wudidamaozi/signal_sensing_accelerator/report/figures/board_top.jpg

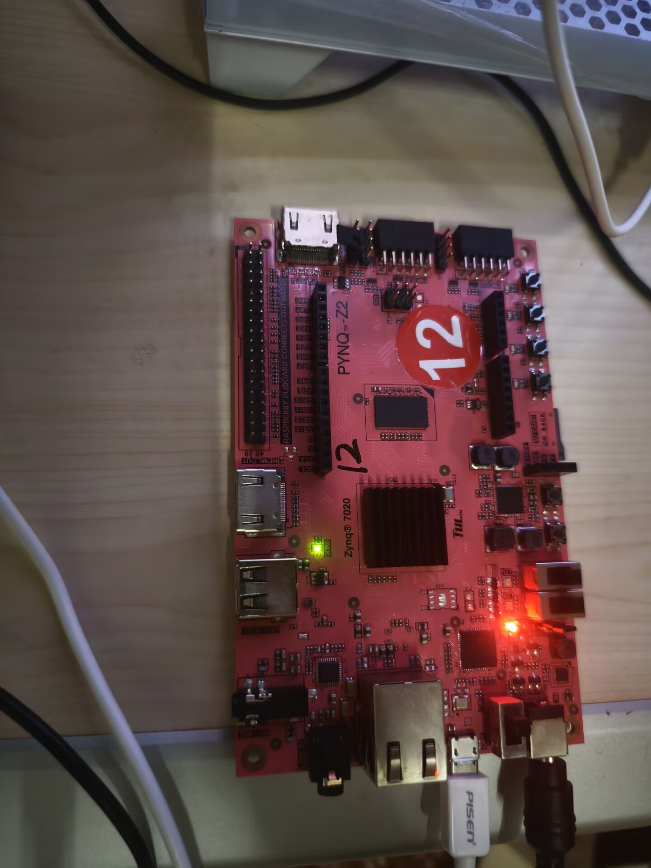
report/figures/board_top.jpg
