wudidamaozi/signal_sensing_accelerator/report/figures/board_oblique.jpg

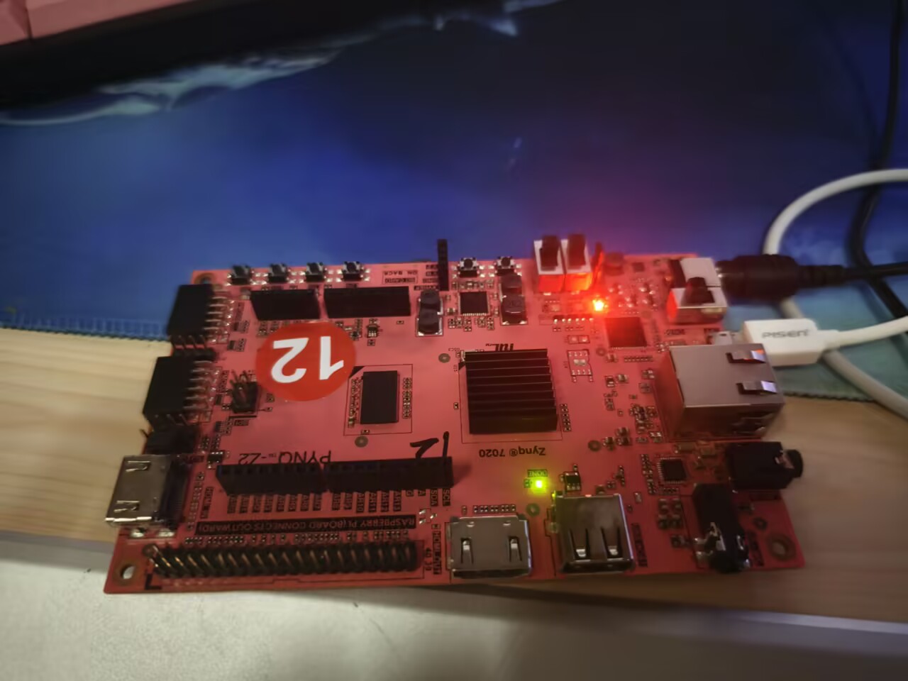
report/figures/board_oblique.jpg
