wudidamaozi/signal_sensing_accelerator/report/README.md

# 基于FPGA的信号感知加速系统技术文档

本目录的正式提交文档为V8，共28页。

- **[阅读技术文档 PDF](基于FPGA的信号感知加速系统技术文档.pdf)**
- **[下载技术文档 Word](基于FPGA的信号感知加速系统技术文档.docx)**

文档内容、性能数据与已确认版本一致，本次只调整文件名称与阅读入口。正式Word与PDF采用完整中文作品名称，源代码与脚本目录保留英文。

## 配套材料

- [报告说明](design_report.md)
- [图表与实板照片](figures/)
- [大模型辅助设计过程](ai_collaboration.md)及[交互选段](ai_collaboration.jsonl)
- [四种方法性能数据](four_method_board_results.csv)
- [原始结果与身份记录](evidence/)
- [从零复现说明](reproduction.md)
