wudidamaozi/signal_sensing_accelerator/src/rtl/README.md

# RTL source index

相同文件按内容合并，不合并同名但不同的私有实现。每个variant均可独立综合。

## classification_native

- `picorv32.v` → [picorv32_0836050971.v](common/picorv32_0836050971.v)
- `int8_accelerator_mmio_m33.sv` → [int8_accelerator_mmio_m33_3799ce2c50.sv](common/int8_accelerator_mmio_m33_3799ce2c50.sv)
- `int8_gemm_controller_m32.sv` → [int8_gemm_controller_m32_1716969adc.sv](common/int8_gemm_controller_m32_1716969adc.sv)
- `int8_input_window_loader_m33.sv` → [int8_input_window_loader_m33_1b4d976766.sv](common/int8_input_window_loader_m33_1b4d976766.sv)
- `int8_layer_postprocess_controller.sv` → [int8_layer_postprocess_controller_28c6c0fac2.sv](common/int8_layer_postprocess_controller_28c6c0fac2.sv)
- `int8_max_pool2.sv` → [int8_max_pool2_0a0ae2d4c0.sv](common/int8_max_pool2_0a0ae2d4c0.sv)
- `int8_outer_product_4x4.sv` → [int8_outer_product_4x4_0622b5f9d8.sv](common/int8_outer_product_4x4_0622b5f9d8.sv)
- `int8_requantize_relu.sv` → [int8_requantize_relu_98dfb3d442.sv](common/int8_requantize_relu_98dfb3d442.sv)
- `int8_stream_gap.sv` → [int8_stream_gap_971eea06c3.sv](common/int8_stream_gap_971eea06c3.sv)
- `int8_weight_tile_loader.sv` → [int8_weight_tile_loader_4e19926822.sv](common/int8_weight_tile_loader_4e19926822.sv)
- `m30_network_replay.sv` → [m30_network_replay_6fcaa0b044.sv](common/m30_network_replay_6fcaa0b044.sv)
- `picorv32_accel_soc.sv` → [picorv32_accel_soc_ba20cb8e85.sv](common/picorv32_accel_soc_ba20cb8e85.sv)
- `pynq_r14_m37_usb_top.sv` → [pynq_r14_m37_usb_top_d0eacc5328.sv](common/pynq_r14_m37_usb_top_d0eacc5328.sv)
- `simple_dual_port_bram_32.sv` → [simple_dual_port_bram_32_69316b4be8.sv](common/simple_dual_port_bram_32_69316b4be8.sv)
- `simple_dual_port_bram_8.sv` → [simple_dual_port_bram_8_8822d650fa.sv](common/simple_dual_port_bram_8_8822d650fa.sv)

## classification_hls4ml

- `picorv32.v` → [picorv32_0836050971.v](common/picorv32_0836050971.v)
- `public_cnn.v` → [public_cnn_613a852ffb.v](common/public_cnn_613a852ffb.v)
- `public_cnn_compute_output_buffer_1d_array_ap_int_8_2u_array_ap_int_32_32u_config2_s.v` → [public_cnn_compute_output_buffer_1d_array_ap_int_8_2u_array_ap_i_f963e03465.v](common/public_cnn_compute_output_buffer_1d_array_ap_int_8_2u_array_ap_i_f963e03465.v)
- `public_cnn_compute_output_buffer_1d_array_ap_int_8_32u_array_ap_int_32_64u_config5_s.v` → [public_cnn_compute_output_buffer_1d_array_ap_int_8_32u_array_ap__8306ac9084.v](common/public_cnn_compute_output_buffer_1d_array_ap_int_8_32u_array_ap__8306ac9084.v)
- `public_cnn_compute_output_buffer_1d_array_ap_int_8_64u_array_ap_int_32_64u_config8_s.v` → [public_cnn_compute_output_buffer_1d_array_ap_int_8_64u_array_ap__76f975a701.v](common/public_cnn_compute_output_buffer_1d_array_ap_int_8_64u_array_ap__76f975a701.v)
- `public_cnn_conv_1d_cl_array_ap_int_8_2u_array_ap_int_32_32u_config2_s.v` → [public_cnn_conv_1d_cl_array_ap_int_8_2u_array_ap_int_32_32u_conf_8c45bdf6fb.v](common/public_cnn_conv_1d_cl_array_ap_int_8_2u_array_ap_int_32_32u_conf_8c45bdf6fb.v)
- `public_cnn_conv_1d_cl_array_ap_int_8_32u_array_ap_int_32_64u_config5_s.v` → [public_cnn_conv_1d_cl_array_ap_int_8_32u_array_ap_int_32_64u_con_a865e45c8b.v](common/public_cnn_conv_1d_cl_array_ap_int_8_32u_array_ap_int_32_64u_con_a865e45c8b.v)
- `public_cnn_conv_1d_cl_array_ap_int_8_64u_array_ap_int_32_64u_config8_s.v` → [public_cnn_conv_1d_cl_array_ap_int_8_64u_array_ap_int_32_64u_con_ced2e0c10d.v](common/public_cnn_conv_1d_cl_array_ap_int_8_64u_array_ap_int_32_64u_con_ced2e0c10d.v)
- `public_cnn_dense_array_ap_int_8_64u_array_ap_int_32_4u_config11_s.v` → [public_cnn_dense_array_ap_int_8_64u_array_ap_int_32_4u_config11__b1404e3907.v](common/public_cnn_dense_array_ap_int_8_64u_array_ap_int_32_4u_config11__b1404e3907.v)
- `public_cnn_dense_resource_rf_gt_nin_rem0_ap_int_8_ap_int_32_config2_mult_s.v` → [public_cnn_dense_resource_rf_gt_nin_rem0_ap_int_8_ap_int_32_conf_ee845bf7ef.v](common/public_cnn_dense_resource_rf_gt_nin_rem0_ap_int_8_ap_int_32_conf_ee845bf7ef.v)
- `public_cnn_dense_resource_rf_gt_nin_rem0_ap_int_8_ap_int_32_config2_mult_s_outidx_2.v` → [public_cnn_dense_resource_rf_gt_nin_rem0_ap_int_8_ap_int_32_conf_812364fb16.v](common/public_cnn_dense_resource_rf_gt_nin_rem0_ap_int_8_ap_int_32_conf_812364fb16.v)
- `public_cnn_dense_resource_rf_gt_nin_rem0_ap_int_8_ap_int_32_config2_mult_s_w2_V.v` → [public_cnn_dense_resource_rf_gt_nin_rem0_ap_int_8_ap_int_32_conf_0eb14951e0.v](common/public_cnn_dense_resource_rf_gt_nin_rem0_ap_int_8_ap_int_32_conf_0eb14951e0.v)
- `public_cnn_dense_resource_rf_gt_nin_rem0_ap_int_8_ap_int_32_config5_mult_s.v` → [public_cnn_dense_resource_rf_gt_nin_rem0_ap_int_8_ap_int_32_conf_16612c6930.v](common/public_cnn_dense_resource_rf_gt_nin_rem0_ap_int_8_ap_int_32_conf_16612c6930.v)
- `public_cnn_dense_resource_rf_gt_nin_rem0_ap_int_8_ap_int_32_config5_mult_s_outidx_1.v` → [public_cnn_dense_resource_rf_gt_nin_rem0_ap_int_8_ap_int_32_conf_3170edeac6.v](common/public_cnn_dense_resource_rf_gt_nin_rem0_ap_int_8_ap_int_32_conf_3170edeac6.v)
- `public_cnn_dense_resource_rf_gt_nin_rem0_ap_int_8_ap_int_32_config5_mult_s_w5_V.v` → [public_cnn_dense_resource_rf_gt_nin_rem0_ap_int_8_ap_int_32_conf_83562274df.v](common/public_cnn_dense_resource_rf_gt_nin_rem0_ap_int_8_ap_int_32_conf_83562274df.v)
- `public_cnn_dense_resource_rf_gt_nin_rem0_ap_int_8_ap_int_32_config8_mult_s.v` → [public_cnn_dense_resource_rf_gt_nin_rem0_ap_int_8_ap_int_32_conf_4edea8b71d.v](common/public_cnn_dense_resource_rf_gt_nin_rem0_ap_int_8_ap_int_32_conf_4edea8b71d.v)
- `public_cnn_dense_resource_rf_gt_nin_rem0_ap_int_8_ap_int_32_config8_mult_s_outidx.v` → [public_cnn_dense_resource_rf_gt_nin_rem0_ap_int_8_ap_int_32_conf_05a0e2ae97.v](common/public_cnn_dense_resource_rf_gt_nin_rem0_ap_int_8_ap_int_32_conf_05a0e2ae97.v)
- `public_cnn_dense_resource_rf_gt_nin_rem0_ap_int_8_ap_int_32_config8_mult_s_w8_V.v` → [public_cnn_dense_resource_rf_gt_nin_rem0_ap_int_8_ap_int_32_conf_f6bc840b84.v](common/public_cnn_dense_resource_rf_gt_nin_rem0_ap_int_8_ap_int_32_conf_f6bc840b84.v)
- `public_cnn_dense_resource_rf_leq_nin_ap_int_8_ap_int_32_config11_s.v` → [public_cnn_dense_resource_rf_leq_nin_ap_int_8_ap_int_32_config11_7f0264f9b0.v](common/public_cnn_dense_resource_rf_leq_nin_ap_int_8_ap_int_32_config11_7f0264f9b0.v)
- `public_cnn_dense_resource_rf_leq_nin_ap_int_8_ap_int_32_config11_s_w11_V.v` → [public_cnn_dense_resource_rf_leq_nin_ap_int_8_ap_int_32_config11_0605cbb6cc.v](common/public_cnn_dense_resource_rf_leq_nin_ap_int_8_ap_int_32_config11_0605cbb6cc.v)
- `public_cnn_edge_gap_array_ap_int_8_64u_array_ap_int_8_64u_config10_s.v` → [public_cnn_edge_gap_array_ap_int_8_64u_array_ap_int_8_64u_config_59c98af666.v](common/public_cnn_edge_gap_array_ap_int_8_64u_array_ap_int_8_64u_config_59c98af666.v)
- `public_cnn_edge_requant_array_ap_int_32_32u_array_ap_int_8_32u_config3_s.v` → [public_cnn_edge_requant_array_ap_int_32_32u_array_ap_int_8_32u_c_f088b455ca.v](common/public_cnn_edge_requant_array_ap_int_32_32u_array_ap_int_8_32u_c_f088b455ca.v)
- `public_cnn_edge_requant_array_ap_int_32_64u_array_ap_int_8_64u_config6_s.v` → [public_cnn_edge_requant_array_ap_int_32_64u_array_ap_int_8_64u_c_c8b5be7ced.v](common/public_cnn_edge_requant_array_ap_int_32_64u_array_ap_int_8_64u_c_c8b5be7ced.v)
- `public_cnn_edge_requant_array_ap_int_32_64u_array_ap_int_8_64u_config9_s.v` → [public_cnn_edge_requant_array_ap_int_32_64u_array_ap_int_8_64u_c_0c2435c09d.v](common/public_cnn_edge_requant_array_ap_int_32_64u_array_ap_int_8_64u_c_0c2435c09d.v)
- `public_cnn_fifo_w1024_d2_S.v` → [public_cnn_fifo_w1024_d2_s_4359fc197e.v](common/public_cnn_fifo_w1024_d2_s_4359fc197e.v)
- `public_cnn_fifo_w16_d2_S.v` → [public_cnn_fifo_w16_d2_s_8f4cb74737.v](common/public_cnn_fifo_w16_d2_s_8f4cb74737.v)
- `public_cnn_fifo_w2048_d2_S.v` → [public_cnn_fifo_w2048_d2_s_a7a66d2959.v](common/public_cnn_fifo_w2048_d2_s_a7a66d2959.v)
- `public_cnn_fifo_w256_d2_S.v` → [public_cnn_fifo_w256_d2_s_690677c5bc.v](common/public_cnn_fifo_w256_d2_s_690677c5bc.v)
- `public_cnn_fifo_w512_d1_S.v` → [public_cnn_fifo_w512_d1_s_ea1562b911.v](common/public_cnn_fifo_w512_d1_s_ea1562b911.v)
- `public_cnn_fifo_w512_d2_S.v` → [public_cnn_fifo_w512_d2_s_46d1deb5f7.v](common/public_cnn_fifo_w512_d2_s_46d1deb5f7.v)
- `public_cnn_mac_muladd_8s_8s_16s_17_4_1.v` → [public_cnn_mac_muladd_8s_8s_16s_17_4_1_40efa62376.v](common/public_cnn_mac_muladd_8s_8s_16s_17_4_1_40efa62376.v)
- `public_cnn_mac_muladd_8s_8s_32ns_32_4_1.v` → [public_cnn_mac_muladd_8s_8s_32ns_32_4_1_18172d5f05.v](common/public_cnn_mac_muladd_8s_8s_32ns_32_4_1_18172d5f05.v)
- `public_cnn_mul_8s_8s_16_1_1.v` → [public_cnn_mul_8s_8s_16_1_1_e2bcf43006.v](common/public_cnn_mul_8s_8s_16_1_1_e2bcf43006.v)
- `public_cnn_mux_164_8_1_1.v` → [public_cnn_mux_164_8_1_1_4d54957741.v](common/public_cnn_mux_164_8_1_1_4d54957741.v)
- `public_cnn_mux_42_32_1_1.v` → [public_cnn_mux_42_32_1_1_5a4bb4b7b5.v](common/public_cnn_mux_42_32_1_1_5a4bb4b7b5.v)
- `public_cnn_mux_646_32_1_1.v` → [public_cnn_mux_646_32_1_1_a496ced3c2.v](common/public_cnn_mux_646_32_1_1_a496ced3c2.v)
- `public_cnn_mux_646_8_1_1.v` → [public_cnn_mux_646_8_1_1_faf9fe0a66.v](common/public_cnn_mux_646_8_1_1_faf9fe0a66.v)
- `public_cnn_pooling1d_cl_array_ap_int_8_32u_array_ap_int_8_32u_config4_s.v` → [public_cnn_pooling1d_cl_array_ap_int_8_32u_array_ap_int_8_32u_co_f8a008766f.v](common/public_cnn_pooling1d_cl_array_ap_int_8_32u_array_ap_int_8_32u_co_f8a008766f.v)
- `public_cnn_pooling1d_cl_array_ap_int_8_64u_array_ap_int_8_64u_config7_s.v` → [public_cnn_pooling1d_cl_array_ap_int_8_64u_array_ap_int_8_64u_co_a042e5c248.v](common/public_cnn_pooling1d_cl_array_ap_int_8_64u_array_ap_int_8_64u_co_a042e5c248.v)
- `public_cnn_regslice_both.v` → [public_cnn_regslice_both_455fa0e3b6.v](common/public_cnn_regslice_both_455fa0e3b6.v)
- `public_cnn_start_for_conv_1d_cl_array_ap_int_8_2u_array_ap_int_32_32u_config2_U0.v` → [public_cnn_start_for_conv_1d_cl_array_ap_int_8_2u_array_ap_int_3_fc5bb173f6.v](common/public_cnn_start_for_conv_1d_cl_array_ap_int_8_2u_array_ap_int_3_fc5bb173f6.v)
- `public_cnn_start_for_conv_1d_cl_array_ap_int_8_32u_array_ap_int_32_64u_config5_U0.v` → [public_cnn_start_for_conv_1d_cl_array_ap_int_8_32u_array_ap_int__700c8c4683.v](common/public_cnn_start_for_conv_1d_cl_array_ap_int_8_32u_array_ap_int__700c8c4683.v)
- `public_cnn_start_for_conv_1d_cl_array_ap_int_8_64u_array_ap_int_32_64u_config8_U0.v` → [public_cnn_start_for_conv_1d_cl_array_ap_int_8_64u_array_ap_int__f5fe1c8c80.v](common/public_cnn_start_for_conv_1d_cl_array_ap_int_8_64u_array_ap_int__f5fe1c8c80.v)
- `public_cnn_start_for_dense_array_ap_int_8_64u_array_ap_int_32_4u_config11_U0.v` → [public_cnn_start_for_dense_array_ap_int_8_64u_array_ap_int_32_4u_1f6f777111.v](common/public_cnn_start_for_dense_array_ap_int_8_64u_array_ap_int_32_4u_1f6f777111.v)
- `public_cnn_start_for_edge_gap_array_ap_int_8_64u_array_ap_int_8_64u_config10_U0.v` → [public_cnn_start_for_edge_gap_array_ap_int_8_64u_array_ap_int_8__ca4464d58e.v](common/public_cnn_start_for_edge_gap_array_ap_int_8_64u_array_ap_int_8__ca4464d58e.v)
- `public_cnn_start_for_edge_requant_array_ap_int_32_32u_array_ap_int_8_32u_config3_U0.v` → [public_cnn_start_for_edge_requant_array_ap_int_32_32u_array_ap_i_4d4d6b3682.v](common/public_cnn_start_for_edge_requant_array_ap_int_32_32u_array_ap_i_4d4d6b3682.v)
- `public_cnn_start_for_edge_requant_array_ap_int_32_64u_array_ap_int_8_64u_config6_U0.v` → [public_cnn_start_for_edge_requant_array_ap_int_32_64u_array_ap_i_9abb88d0a9.v](common/public_cnn_start_for_edge_requant_array_ap_int_32_64u_array_ap_i_9abb88d0a9.v)
- `public_cnn_start_for_edge_requant_array_ap_int_32_64u_array_ap_int_8_64u_config9_U0.v` → [public_cnn_start_for_edge_requant_array_ap_int_32_64u_array_ap_i_6f36ac7276.v](common/public_cnn_start_for_edge_requant_array_ap_int_32_64u_array_ap_i_6f36ac7276.v)
- `public_cnn_start_for_pooling1d_cl_array_ap_int_8_32u_array_ap_int_8_32u_config4_U0.v` → [public_cnn_start_for_pooling1d_cl_array_ap_int_8_32u_array_ap_in_1ae8a94765.v](common/public_cnn_start_for_pooling1d_cl_array_ap_int_8_32u_array_ap_in_1ae8a94765.v)
- `public_cnn_start_for_pooling1d_cl_array_ap_int_8_64u_array_ap_int_8_64u_config7_U0.v` → [public_cnn_start_for_pooling1d_cl_array_ap_int_8_64u_array_ap_in_56fe2aba35.v](common/public_cnn_start_for_pooling1d_cl_array_ap_int_8_64u_array_ap_in_56fe2aba35.v)
- `public_cnn_start_for_zeropad1d_cl_array_ap_int_8_32u_array_ap_int_8_32u_config13_U0.v` → [public_cnn_start_for_zeropad1d_cl_array_ap_int_8_32u_array_ap_in_3bcb6ae762.v](common/public_cnn_start_for_zeropad1d_cl_array_ap_int_8_32u_array_ap_in_3bcb6ae762.v)
- `public_cnn_start_for_zeropad1d_cl_array_ap_int_8_64u_array_ap_int_8_64u_config14_U0.v` → [public_cnn_start_for_zeropad1d_cl_array_ap_int_8_64u_array_ap_in_d10adf3a59.v](common/public_cnn_start_for_zeropad1d_cl_array_ap_int_8_64u_array_ap_in_d10adf3a59.v)
- `public_cnn_zeropad1d_cl_array_ap_int_8_2u_array_ap_int_8_2u_config12_s.v` → [public_cnn_zeropad1d_cl_array_ap_int_8_2u_array_ap_int_8_2u_conf_7416b15e02.v](common/public_cnn_zeropad1d_cl_array_ap_int_8_2u_array_ap_int_8_2u_conf_7416b15e02.v)
- `public_cnn_zeropad1d_cl_array_ap_int_8_32u_array_ap_int_8_32u_config13_s.v` → [public_cnn_zeropad1d_cl_array_ap_int_8_32u_array_ap_int_8_32u_co_c487a04ace.v](common/public_cnn_zeropad1d_cl_array_ap_int_8_32u_array_ap_int_8_32u_co_c487a04ace.v)
- `public_cnn_zeropad1d_cl_array_ap_int_8_64u_array_ap_int_8_64u_config14_s.v` → [public_cnn_zeropad1d_cl_array_ap_int_8_64u_array_ap_int_8_64u_co_c01829a652.v](common/public_cnn_zeropad1d_cl_array_ap_int_8_64u_array_ap_int_8_64u_co_c01829a652.v)
- `hls_network_mmio.sv` → [hls_network_mmio_cf8da6c49e.sv](common/hls_network_mmio_cf8da6c49e.sv)
- `hls_picorv32_soc.sv` → [hls_picorv32_soc_1f9c38afa6.sv](common/hls_picorv32_soc_1f9c38afa6.sv)
- `pynq_r14_hls_usb_top.sv` → [pynq_r14_hls_usb_top_c6f5b64761.sv](common/pynq_r14_hls_usb_top_c6f5b64761.sv)

## classification_im2col

- `picorv32.v` → [picorv32_0836050971.v](common/picorv32_0836050971.v)
- `int8_accelerator_mmio_m33.sv` → [int8_accelerator_mmio_m33_3799ce2c50.sv](common/int8_accelerator_mmio_m33_3799ce2c50.sv)
- `int8_gemm_controller_m32.sv` → [int8_gemm_controller_m32_1716969adc.sv](common/int8_gemm_controller_m32_1716969adc.sv)
- `int8_input_window_loader_m33.sv` → [int8_input_window_loader_m33_1b4d976766.sv](common/int8_input_window_loader_m33_1b4d976766.sv)
- `int8_layer_postprocess_controller.sv` → [int8_layer_postprocess_controller_28c6c0fac2.sv](common/int8_layer_postprocess_controller_28c6c0fac2.sv)
- `int8_max_pool2.sv` → [int8_max_pool2_0a0ae2d4c0.sv](common/int8_max_pool2_0a0ae2d4c0.sv)
- `int8_outer_product_4x4.sv` → [int8_outer_product_4x4_0622b5f9d8.sv](common/int8_outer_product_4x4_0622b5f9d8.sv)
- `int8_requantize_relu.sv` → [int8_requantize_relu_98dfb3d442.sv](common/int8_requantize_relu_98dfb3d442.sv)
- `int8_stream_gap.sv` → [int8_stream_gap_971eea06c3.sv](common/int8_stream_gap_971eea06c3.sv)
- `int8_weight_tile_loader.sv` → [int8_weight_tile_loader_4e19926822.sv](common/int8_weight_tile_loader_4e19926822.sv)
- `m30_network_replay.sv` → [m30_network_replay_6fcaa0b044.sv](common/m30_network_replay_6fcaa0b044.sv)
- `picorv32_accel_soc.sv` → [picorv32_accel_soc_ba20cb8e85.sv](common/picorv32_accel_soc_ba20cb8e85.sv)
- `pynq_r14_im2col_usb_top.sv` → [pynq_r14_im2col_usb_top_d15854cee5.sv](common/pynq_r14_im2col_usb_top_d15854cee5.sv)
- `simple_dual_port_bram_32.sv` → [simple_dual_port_bram_32_69316b4be8.sv](common/simple_dual_port_bram_32_69316b4be8.sv)
- `simple_dual_port_bram_8.sv` → [simple_dual_port_bram_8_8822d650fa.sv](common/simple_dual_port_bram_8_8822d650fa.sv)

## occupancy_native

- `edgeai_axi_lite_bridge.sv` → [edgeai_axi_lite_bridge_55b705aad1.sv](common/edgeai_axi_lite_bridge_55b705aad1.sv)
- `edgeai_host_mailbox.sv` → [edgeai_host_mailbox_f4e1ea7b21.sv](common/edgeai_host_mailbox_f4e1ea7b21.sv)
- `int8_accelerator_mmio_m33.sv` → [int8_accelerator_mmio_m33_8f15b2467b.sv](common/int8_accelerator_mmio_m33_8f15b2467b.sv)
- `int8_gemm_controller_m32.sv` → [int8_gemm_controller_m32_8577552883.sv](common/int8_gemm_controller_m32_8577552883.sv)
- `int8_input_window_loader_gather.sv` → [int8_input_window_loader_gather_81e9d471b7.sv](common/int8_input_window_loader_gather_81e9d471b7.sv)
- `int8_input_window_loader_m33.sv` → [int8_input_window_loader_m33_e1834de3c9.sv](common/int8_input_window_loader_m33_e1834de3c9.sv)
- `int8_layer_postprocess_controller.sv` → [int8_layer_postprocess_controller_3c490b37c0.sv](common/int8_layer_postprocess_controller_3c490b37c0.sv)
- `int8_max_pool2.sv` → [int8_max_pool2_7af1883049.sv](common/int8_max_pool2_7af1883049.sv)
- `int8_outer_product_4x4.sv` → [int8_outer_product_4x4_cee69d734f.sv](common/int8_outer_product_4x4_cee69d734f.sv)
- `int8_requantize_relu.sv` → [int8_requantize_relu_005e3f0635.sv](common/int8_requantize_relu_005e3f0635.sv)
- `int8_stream_gap.sv` → [int8_stream_gap_54922f62b9.sv](common/int8_stream_gap_54922f62b9.sv)
- `int8_weight_tile_loader.sv` → [int8_weight_tile_loader_581be3476b.sv](common/int8_weight_tile_loader_581be3476b.sv)
- `m30_network_replay.sv` → [m30_network_replay_f81f05902d.sv](common/m30_network_replay_f81f05902d.sv)
- `occupancy_mailbox.sv` → [occupancy_mailbox_77e3f5e48b.sv](common/occupancy_mailbox_77e3f5e48b.sv)
- `occupancy_service_soc.sv` → [occupancy_service_soc_cf51d80092.sv](common/occupancy_service_soc_cf51d80092.sv)
- `picorv32.v` → [picorv32_fd142889e8.v](common/picorv32_fd142889e8.v)
- `picorv32_accel_soc_host.sv` → [picorv32_accel_soc_host_bcc3fad12d.sv](common/picorv32_accel_soc_host_bcc3fad12d.sv)
- `pynq_o55_jtag_stimulus.sv` → [pynq_o55_jtag_stimulus_74829c4ed3.sv](common/pynq_o55_jtag_stimulus_74829c4ed3.sv)
- `pynq_o55_jtag_top.sv` → [pynq_o55_jtag_top_a35337d1af.sv](common/pynq_o55_jtag_top_a35337d1af.sv)
- `simple_dual_port_bram_32.sv` → [simple_dual_port_bram_32_e016a6dd21.sv](common/simple_dual_port_bram_32_e016a6dd21.sv)
- `simple_dual_port_bram_8.sv` → [simple_dual_port_bram_8_1390076600.sv](common/simple_dual_port_bram_8_1390076600.sv)

## occupancy_hls4ml

- `edgeai_axi_lite_bridge.sv` → [edgeai_axi_lite_bridge_55b705aad1.sv](common/edgeai_axi_lite_bridge_55b705aad1.sv)
- `edgeai_host_mailbox.sv` → [edgeai_host_mailbox_f4e1ea7b21.sv](common/edgeai_host_mailbox_f4e1ea7b21.sv)
- `int8_accelerator_mmio_m33.sv` → [int8_accelerator_mmio_m33_d4a8ad517a.sv](common/int8_accelerator_mmio_m33_d4a8ad517a.sv)
- `int8_gemm_controller_m32.sv` → [int8_gemm_controller_m32_b3ed4aff0c.sv](common/int8_gemm_controller_m32_b3ed4aff0c.sv)
- `int8_input_window_loader_m33.sv` → [int8_input_window_loader_m33_8b8bdf9e93.sv](common/int8_input_window_loader_m33_8b8bdf9e93.sv)
- `int8_layer_postprocess_controller.sv` → [int8_layer_postprocess_controller_99a497ee93.sv](common/int8_layer_postprocess_controller_99a497ee93.sv)
- `int8_max_pool2.sv` → [int8_max_pool2_7af1883049.sv](common/int8_max_pool2_7af1883049.sv)
- `int8_outer_product_4x4.sv` → [int8_outer_product_4x4_b9b2021505.sv](common/int8_outer_product_4x4_b9b2021505.sv)
- `int8_requantize_relu.sv` → [int8_requantize_relu_005e3f0635.sv](common/int8_requantize_relu_005e3f0635.sv)
- `int8_stream_gap.sv` → [int8_stream_gap_54922f62b9.sv](common/int8_stream_gap_54922f62b9.sv)
- `int8_weight_tile_loader.sv` → [int8_weight_tile_loader_581be3476b.sv](common/int8_weight_tile_loader_581be3476b.sv)
- `m30_network_replay.sv` → [m30_network_replay_f81f05902d.sv](common/m30_network_replay_f81f05902d.sv)
- `occupancy_hls4ml.v` → [occupancy_hls4ml_739e2e08d4.v](common/occupancy_hls4ml_739e2e08d4.v)
- `occupancy_hls4ml_compute_output_buffer_1d_array_ap_int_8_2u_array_ap_int_32_45u_config2_s.v` → [occupancy_hls4ml_compute_output_buffer_1d_array_ap_int_8_2u_arra_a0191cf008.v](common/occupancy_hls4ml_compute_output_buffer_1d_array_ap_int_8_2u_arra_a0191cf008.v)
- `occupancy_hls4ml_compute_output_buffer_1d_array_ap_int_8_45u_array_ap_int_32_9u_config4_s.v` → [occupancy_hls4ml_compute_output_buffer_1d_array_ap_int_8_45u_arr_69e6528d79.v](common/occupancy_hls4ml_compute_output_buffer_1d_array_ap_int_8_45u_arr_69e6528d79.v)
- `occupancy_hls4ml_conv_1d_cl_array_ap_int_8_2u_array_ap_int_32_45u_config2_s.v` → [occupancy_hls4ml_conv_1d_cl_array_ap_int_8_2u_array_ap_int_32_45_af52de4f18.v](common/occupancy_hls4ml_conv_1d_cl_array_ap_int_8_2u_array_ap_int_32_45_af52de4f18.v)
- `occupancy_hls4ml_conv_1d_cl_array_ap_int_8_45u_array_ap_int_32_9u_config4_s.v` → [occupancy_hls4ml_conv_1d_cl_array_ap_int_8_45u_array_ap_int_32_9_87aff9bb66.v](common/occupancy_hls4ml_conv_1d_cl_array_ap_int_8_45u_array_ap_int_32_9_87aff9bb66.v)
- `occupancy_hls4ml_dense_array_ap_int_8_32u_array_ap_int_32_2u_config9_s.v` → [occupancy_hls4ml_dense_array_ap_int_8_32u_array_ap_int_32_2u_con_b00aee4658.v](common/occupancy_hls4ml_dense_array_ap_int_8_32u_array_ap_int_32_2u_con_b00aee4658.v)
- `occupancy_hls4ml_dense_array_ap_int_8_9u_array_ap_int_32_32u_config7_s.v` → [occupancy_hls4ml_dense_array_ap_int_8_9u_array_ap_int_32_32u_con_635c6483cd.v](common/occupancy_hls4ml_dense_array_ap_int_8_9u_array_ap_int_32_32u_con_635c6483cd.v)
- `occupancy_hls4ml_dense_resource_rf_gt_nin_rem0_ap_int_8_ap_int_32_config2_mult_s.v` → [occupancy_hls4ml_dense_resource_rf_gt_nin_rem0_ap_int_8_ap_int_3_af4e3e7450.v](common/occupancy_hls4ml_dense_resource_rf_gt_nin_rem0_ap_int_8_ap_int_3_af4e3e7450.v)
- `occupancy_hls4ml_dense_resource_rf_gt_nin_rem0_ap_int_8_ap_int_32_config2_mult_s_outidx_1.v` → [occupancy_hls4ml_dense_resource_rf_gt_nin_rem0_ap_int_8_ap_int_3_ea117b0cbe.v](common/occupancy_hls4ml_dense_resource_rf_gt_nin_rem0_ap_int_8_ap_int_3_ea117b0cbe.v)
- `occupancy_hls4ml_dense_resource_rf_gt_nin_rem0_ap_int_8_ap_int_32_config2_mult_s_w2_V.v` → [occupancy_hls4ml_dense_resource_rf_gt_nin_rem0_ap_int_8_ap_int_3_4f19854310.v](common/occupancy_hls4ml_dense_resource_rf_gt_nin_rem0_ap_int_8_ap_int_3_4f19854310.v)
- `occupancy_hls4ml_dense_resource_rf_gt_nin_rem0_ap_int_8_ap_int_32_config7_s.v` → [occupancy_hls4ml_dense_resource_rf_gt_nin_rem0_ap_int_8_ap_int_3_32c872f560.v](common/occupancy_hls4ml_dense_resource_rf_gt_nin_rem0_ap_int_8_ap_int_3_32c872f560.v)
- `occupancy_hls4ml_dense_resource_rf_gt_nin_rem0_ap_int_8_ap_int_32_config7_s_outidx.v` → [occupancy_hls4ml_dense_resource_rf_gt_nin_rem0_ap_int_8_ap_int_3_c02901979f.v](common/occupancy_hls4ml_dense_resource_rf_gt_nin_rem0_ap_int_8_ap_int_3_c02901979f.v)
- `occupancy_hls4ml_dense_resource_rf_gt_nin_rem0_ap_int_8_ap_int_32_config7_s_w7_V.v` → [occupancy_hls4ml_dense_resource_rf_gt_nin_rem0_ap_int_8_ap_int_3_448563d52b.v](common/occupancy_hls4ml_dense_resource_rf_gt_nin_rem0_ap_int_8_ap_int_3_448563d52b.v)
- `occupancy_hls4ml_dense_resource_rf_leq_nin_ap_int_8_ap_int_32_config4_mult_s.v` → [occupancy_hls4ml_dense_resource_rf_leq_nin_ap_int_8_ap_int_32_co_c840dd55e9.v](common/occupancy_hls4ml_dense_resource_rf_leq_nin_ap_int_8_ap_int_32_co_c840dd55e9.v)
- `occupancy_hls4ml_dense_resource_rf_leq_nin_ap_int_8_ap_int_32_config4_mult_s_w4_V.v` → [occupancy_hls4ml_dense_resource_rf_leq_nin_ap_int_8_ap_int_32_co_cb8a996362.v](common/occupancy_hls4ml_dense_resource_rf_leq_nin_ap_int_8_ap_int_32_co_cb8a996362.v)
- `occupancy_hls4ml_dense_resource_rf_leq_nin_ap_int_8_ap_int_32_config9_s.v` → [occupancy_hls4ml_dense_resource_rf_leq_nin_ap_int_8_ap_int_32_co_1b3446e260.v](common/occupancy_hls4ml_dense_resource_rf_leq_nin_ap_int_8_ap_int_32_co_1b3446e260.v)
- `occupancy_hls4ml_dense_resource_rf_leq_nin_ap_int_8_ap_int_32_config9_s_w9_V.v` → [occupancy_hls4ml_dense_resource_rf_leq_nin_ap_int_8_ap_int_32_co_47dffd2459.v](common/occupancy_hls4ml_dense_resource_rf_leq_nin_ap_int_8_ap_int_32_co_47dffd2459.v)
- `occupancy_hls4ml_fifo_w1024_d1_S.v` → [occupancy_hls4ml_fifo_w1024_d1_s_13b915fb53.v](common/occupancy_hls4ml_fifo_w1024_d1_s_13b915fb53.v)
- `occupancy_hls4ml_fifo_w1440_d2_S.v` → [occupancy_hls4ml_fifo_w1440_d2_s_1ca7b11681.v](common/occupancy_hls4ml_fifo_w1440_d2_s_1ca7b11681.v)
- `occupancy_hls4ml_fifo_w256_d1_S.v` → [occupancy_hls4ml_fifo_w256_d1_s_0e199a63ec.v](common/occupancy_hls4ml_fifo_w256_d1_s_0e199a63ec.v)
- `occupancy_hls4ml_fifo_w288_d2_S.v` → [occupancy_hls4ml_fifo_w288_d2_s_de0effdc4c.v](common/occupancy_hls4ml_fifo_w288_d2_s_de0effdc4c.v)
- `occupancy_hls4ml_fifo_w360_d2_S.v` → [occupancy_hls4ml_fifo_w360_d2_s_e760b69707.v](common/occupancy_hls4ml_fifo_w360_d2_s_e760b69707.v)
- `occupancy_hls4ml_fifo_w72_d2_S.v` → [occupancy_hls4ml_fifo_w72_d2_s_ad5e9bc59d.v](common/occupancy_hls4ml_fifo_w72_d2_s_ad5e9bc59d.v)
- `occupancy_hls4ml_mac_muladd_8s_7s_32ns_32_4_1.v` → [occupancy_hls4ml_mac_muladd_8s_7s_32ns_32_4_1_a8f9f0dcbd.v](common/occupancy_hls4ml_mac_muladd_8s_7s_32ns_32_4_1_a8f9f0dcbd.v)
- `occupancy_hls4ml_mac_muladd_8s_8s_20ns_20_4_1.v` → [occupancy_hls4ml_mac_muladd_8s_8s_20ns_20_4_1_ad6e5e1b74.v](common/occupancy_hls4ml_mac_muladd_8s_8s_20ns_20_4_1_ad6e5e1b74.v)
- `occupancy_hls4ml_mac_muladd_8s_8s_20s_21_4_1.v` → [occupancy_hls4ml_mac_muladd_8s_8s_20s_21_4_1_537da2484a.v](common/occupancy_hls4ml_mac_muladd_8s_8s_20s_21_4_1_537da2484a.v)
- `occupancy_hls4ml_mac_muladd_8s_8s_24ns_24_4_1.v` → [occupancy_hls4ml_mac_muladd_8s_8s_24ns_24_4_1_42d8c5cada.v](common/occupancy_hls4ml_mac_muladd_8s_8s_24ns_24_4_1_42d8c5cada.v)
- `occupancy_hls4ml_mac_muladd_8s_8s_32ns_32_4_1.v` → [occupancy_hls4ml_mac_muladd_8s_8s_32ns_32_4_1_7b8f698e0e.v](common/occupancy_hls4ml_mac_muladd_8s_8s_32ns_32_4_1_7b8f698e0e.v)
- `occupancy_hls4ml_mmio.sv` → [occupancy_hls4ml_mmio_baa5bfe9da.sv](common/occupancy_hls4ml_mmio_baa5bfe9da.sv)
- `occupancy_hls4ml_mul_3ns_7ns_9_1_1.v` → [occupancy_hls4ml_mul_3ns_7ns_9_1_1_a4586b8a23.v](common/occupancy_hls4ml_mul_3ns_7ns_9_1_1_a4586b8a23.v)
- `occupancy_hls4ml_mux_104411_8_1_1.v` → [occupancy_hls4ml_mux_104411_8_1_1_a3a8b39f8d.v](common/occupancy_hls4ml_mux_104411_8_1_1_a3a8b39f8d.v)
- `occupancy_hls4ml_mux_325_8_1_1.v` → [occupancy_hls4ml_mux_325_8_1_1_1080ba175a.v](common/occupancy_hls4ml_mux_325_8_1_1_1080ba175a.v)
- `occupancy_hls4ml_mux_42_32_1_1.v` → [occupancy_hls4ml_mux_42_32_1_1_589db6b16c.v](common/occupancy_hls4ml_mux_42_32_1_1_589db6b16c.v)
- `occupancy_hls4ml_mux_646_32_1_1.v` → [occupancy_hls4ml_mux_646_32_1_1_3518e2d780.v](common/occupancy_hls4ml_mux_646_32_1_1_3518e2d780.v)
- `occupancy_hls4ml_occupancy_quant_array_ap_int_32_32u_array_ap_int_8_32u_config8_s.v` → [occupancy_hls4ml_occupancy_quant_array_ap_int_32_32u_array_ap_in_2757058c1b.v](common/occupancy_hls4ml_occupancy_quant_array_ap_int_32_32u_array_ap_in_2757058c1b.v)
- `occupancy_hls4ml_occupancy_quant_array_ap_int_32_45u_array_ap_int_8_45u_config3_s.v` → [occupancy_hls4ml_occupancy_quant_array_ap_int_32_45u_array_ap_in_ba8cca2e55.v](common/occupancy_hls4ml_occupancy_quant_array_ap_int_32_45u_array_ap_in_ba8cca2e55.v)
- `occupancy_hls4ml_occupancy_quant_array_ap_int_32_9u_array_ap_int_8_9u_config5_s.v` → [occupancy_hls4ml_occupancy_quant_array_ap_int_32_9u_array_ap_int_490737dfd7.v](common/occupancy_hls4ml_occupancy_quant_array_ap_int_32_9u_array_ap_int_490737dfd7.v)
- `occupancy_hls4ml_regslice_both.v` → [occupancy_hls4ml_regslice_both_d523ec5629.v](common/occupancy_hls4ml_regslice_both_d523ec5629.v)
- `occupancy_hls4ml_start_for_conv_1d_cl_array_ap_int_8_45u_array_ap_int_32_9u_config4_U0.v` → [occupancy_hls4ml_start_for_conv_1d_cl_array_ap_int_8_45u_array_a_6cc69f3be9.v](common/occupancy_hls4ml_start_for_conv_1d_cl_array_ap_int_8_45u_array_a_6cc69f3be9.v)
- `occupancy_hls4ml_start_for_dense_array_ap_int_8_32u_array_ap_int_32_2u_config9_U0.v` → [occupancy_hls4ml_start_for_dense_array_ap_int_8_32u_array_ap_int_043a2027ba.v](common/occupancy_hls4ml_start_for_dense_array_ap_int_8_32u_array_ap_int_043a2027ba.v)
- `occupancy_hls4ml_start_for_dense_array_ap_int_8_9u_array_ap_int_32_32u_config7_U0.v` → [occupancy_hls4ml_start_for_dense_array_ap_int_8_9u_array_ap_int__f46496f3f1.v](common/occupancy_hls4ml_start_for_dense_array_ap_int_8_9u_array_ap_int__f46496f3f1.v)
- `occupancy_hls4ml_start_for_occupancy_quant_array_ap_int_32_32u_array_ap_int_8_32u_config8_U0.v` → [occupancy_hls4ml_start_for_occupancy_quant_array_ap_int_32_32u_a_fca3598917.v](common/occupancy_hls4ml_start_for_occupancy_quant_array_ap_int_32_32u_a_fca3598917.v)
- `occupancy_hls4ml_start_for_occupancy_quant_array_ap_int_32_45u_array_ap_int_8_45u_config3_U0.v` → [occupancy_hls4ml_start_for_occupancy_quant_array_ap_int_32_45u_a_88b384c393.v](common/occupancy_hls4ml_start_for_occupancy_quant_array_ap_int_32_45u_a_88b384c393.v)
- `occupancy_hls4ml_start_for_occupancy_quant_array_ap_int_32_9u_array_ap_int_8_9u_config5_U0.v` → [occupancy_hls4ml_start_for_occupancy_quant_array_ap_int_32_9u_ar_b87b23ca79.v](common/occupancy_hls4ml_start_for_occupancy_quant_array_ap_int_32_9u_ar_b87b23ca79.v)
- `occupancy_mailbox.sv` → [occupancy_mailbox_77e3f5e48b.sv](common/occupancy_mailbox_77e3f5e48b.sv)
- `occupancy_service_soc.sv` → [occupancy_service_soc_2eeeed9397.sv](common/occupancy_service_soc_2eeeed9397.sv)
- `picorv32.v` → [picorv32_fd142889e8.v](common/picorv32_fd142889e8.v)
- `picorv32_accel_soc_host.sv` → [picorv32_accel_soc_host_bcc3fad12d.sv](common/picorv32_accel_soc_host_bcc3fad12d.sv)
- `pynq_o55_jtag_stimulus.sv` → [pynq_o55_jtag_stimulus_a522e1f2dd.sv](common/pynq_o55_jtag_stimulus_a522e1f2dd.sv)
- `pynq_o55_jtag_top.sv` → [pynq_o55_jtag_top_138cdcc439.sv](common/pynq_o55_jtag_top_138cdcc439.sv)
- `simple_dual_port_bram_32.sv` → [simple_dual_port_bram_32_e016a6dd21.sv](common/simple_dual_port_bram_32_e016a6dd21.sv)
- `simple_dual_port_bram_8.sv` → [simple_dual_port_bram_8_1390076600.sv](common/simple_dual_port_bram_8_1390076600.sv)

## occupancy_im2col

- `picorv32.v` → [picorv32_0836050971.v](common/picorv32_0836050971.v)
- `edgeai_axi_lite_bridge.sv` → [edgeai_axi_lite_bridge_9947dc2c55.sv](common/edgeai_axi_lite_bridge_9947dc2c55.sv)
- `edgeai_host_mailbox.sv` → [edgeai_host_mailbox_c78a5b511c.sv](common/edgeai_host_mailbox_c78a5b511c.sv)
- `int8_accelerator_mmio_m33.sv` → [int8_accelerator_mmio_m33_3799ce2c50.sv](common/int8_accelerator_mmio_m33_3799ce2c50.sv)
- `int8_gemm_controller_m32.sv` → [int8_gemm_controller_m32_1716969adc.sv](common/int8_gemm_controller_m32_1716969adc.sv)
- `int8_input_window_loader_m33.sv` → [int8_input_window_loader_m33_1b4d976766.sv](common/int8_input_window_loader_m33_1b4d976766.sv)
- `int8_layer_postprocess_controller.sv` → [int8_layer_postprocess_controller_28c6c0fac2.sv](common/int8_layer_postprocess_controller_28c6c0fac2.sv)
- `int8_max_pool2.sv` → [int8_max_pool2_0a0ae2d4c0.sv](common/int8_max_pool2_0a0ae2d4c0.sv)
- `int8_outer_product_4x4.sv` → [int8_outer_product_4x4_0622b5f9d8.sv](common/int8_outer_product_4x4_0622b5f9d8.sv)
- `int8_requantize_relu.sv` → [int8_requantize_relu_98dfb3d442.sv](common/int8_requantize_relu_98dfb3d442.sv)
- `int8_stream_gap.sv` → [int8_stream_gap_971eea06c3.sv](common/int8_stream_gap_971eea06c3.sv)
- `int8_weight_tile_loader.sv` → [int8_weight_tile_loader_4e19926822.sv](common/int8_weight_tile_loader_4e19926822.sv)
- `m30_network_replay.sv` → [m30_network_replay_6fcaa0b044.sv](common/m30_network_replay_6fcaa0b044.sv)
- `occupancy_mailbox.sv` → [occupancy_mailbox_7499c2dfb6.sv](common/occupancy_mailbox_7499c2dfb6.sv)
- `occupancy_service_soc.sv` → [occupancy_service_soc_2b6fdd5938.sv](common/occupancy_service_soc_2b6fdd5938.sv)
- `picorv32_accel_soc_host.sv` → [picorv32_accel_soc_host_d49f64ce85.sv](common/picorv32_accel_soc_host_d49f64ce85.sv)
- `pynq_o55_jtag_stimulus.sv` → [pynq_o55_jtag_stimulus_dd36bb03f3.sv](common/pynq_o55_jtag_stimulus_dd36bb03f3.sv)
- `pynq_o55_jtag_top.sv` → [pynq_o55_jtag_top_13be7250d9.sv](common/pynq_o55_jtag_top_13be7250d9.sv)
- `simple_dual_port_bram_32.sv` → [simple_dual_port_bram_32_69316b4be8.sv](common/simple_dual_port_bram_32_69316b4be8.sv)
- `simple_dual_port_bram_8.sv` → [simple_dual_port_bram_8_8822d650fa.sv](common/simple_dual_port_bram_8_8822d650fa.sv)

## classification_live

- `picorv32.v` → [picorv32_0836050971.v](common/picorv32_0836050971.v)
- `edgeai_axi_lite_bridge.sv` → [edgeai_axi_lite_bridge_9947dc2c55.sv](common/edgeai_axi_lite_bridge_9947dc2c55.sv)
- `edgeai_class_live_top.sv` → [edgeai_class_live_top_dc3e55a420.sv](common/edgeai_class_live_top_dc3e55a420.sv)
- `edgeai_host_mailbox.sv` → [edgeai_host_mailbox_c78a5b511c.sv](common/edgeai_host_mailbox_c78a5b511c.sv)
- `edgeai_vio_axi_master.sv` → [edgeai_vio_axi_master_fc7a07e9af.sv](common/edgeai_vio_axi_master_fc7a07e9af.sv)
- `int8_accelerator_mmio_m33.sv` → [int8_accelerator_mmio_m33_3799ce2c50.sv](common/int8_accelerator_mmio_m33_3799ce2c50.sv)
- `int8_gemm_controller_m32.sv` → [int8_gemm_controller_m32_1716969adc.sv](common/int8_gemm_controller_m32_1716969adc.sv)
- `int8_input_window_loader_m33.sv` → [int8_input_window_loader_m33_1b4d976766.sv](common/int8_input_window_loader_m33_1b4d976766.sv)
- `int8_layer_postprocess_controller.sv` → [int8_layer_postprocess_controller_28c6c0fac2.sv](common/int8_layer_postprocess_controller_28c6c0fac2.sv)
- `int8_max_pool2.sv` → [int8_max_pool2_0a0ae2d4c0.sv](common/int8_max_pool2_0a0ae2d4c0.sv)
- `int8_outer_product_4x4.sv` → [int8_outer_product_4x4_0622b5f9d8.sv](common/int8_outer_product_4x4_0622b5f9d8.sv)
- `int8_requantize_relu.sv` → [int8_requantize_relu_98dfb3d442.sv](common/int8_requantize_relu_98dfb3d442.sv)
- `int8_stream_gap.sv` → [int8_stream_gap_971eea06c3.sv](common/int8_stream_gap_971eea06c3.sv)
- `int8_weight_tile_loader.sv` → [int8_weight_tile_loader_4e19926822.sv](common/int8_weight_tile_loader_4e19926822.sv)
- `m30_network_replay.sv` → [m30_network_replay_6fcaa0b044.sv](common/m30_network_replay_6fcaa0b044.sv)
- `picorv32_accel_soc_host.sv` → [picorv32_accel_soc_host_d49f64ce85.sv](common/picorv32_accel_soc_host_d49f64ce85.sv)
- `pynq_o55_jtag_stimulus.sv` → [pynq_o55_jtag_stimulus_2779553507.sv](common/pynq_o55_jtag_stimulus_2779553507.sv)
- `pynq_o55_jtag_top.sv` → [pynq_o55_jtag_top_04bbe199fb.sv](common/pynq_o55_jtag_top_04bbe199fb.sv)
- `simple_dual_port_bram_32.sv` → [simple_dual_port_bram_32_69316b4be8.sv](common/simple_dual_port_bram_32_69316b4be8.sv)
- `simple_dual_port_bram_8.sv` → [simple_dual_port_bram_8_8822d650fa.sv](common/simple_dual_port_bram_8_8822d650fa.sv)

## occupancy_live

- `picorv32.v` → [picorv32_fd142889e8.v](common/picorv32_fd142889e8.v)
- `edgeai_axi_lite_bridge.sv` → [edgeai_axi_lite_bridge_55b705aad1.sv](common/edgeai_axi_lite_bridge_55b705aad1.sv)
- `edgeai_host_mailbox.sv` → [edgeai_host_mailbox_f4e1ea7b21.sv](common/edgeai_host_mailbox_f4e1ea7b21.sv)
- `edgeai_o55_live_top.sv` → [edgeai_o55_live_top_6721807c94.sv](common/edgeai_o55_live_top_6721807c94.sv)
- `edgeai_vio_axi_master.sv` → [edgeai_vio_axi_master_a8d10c2cf1.sv](common/edgeai_vio_axi_master_a8d10c2cf1.sv)
- `int8_accelerator_mmio_m33.sv` → [int8_accelerator_mmio_m33_8217e55dc2.sv](common/int8_accelerator_mmio_m33_8217e55dc2.sv)
- `int8_gemm_controller_m32.sv` → [int8_gemm_controller_m32_8577552883.sv](common/int8_gemm_controller_m32_8577552883.sv)
- `int8_input_window_loader_gather.sv` → [int8_input_window_loader_gather_81e9d471b7.sv](common/int8_input_window_loader_gather_81e9d471b7.sv)
- `int8_input_window_loader_m33.sv` → [int8_input_window_loader_m33_e1834de3c9.sv](common/int8_input_window_loader_m33_e1834de3c9.sv)
- `int8_layer_postprocess_controller.sv` → [int8_layer_postprocess_controller_3c490b37c0.sv](common/int8_layer_postprocess_controller_3c490b37c0.sv)
- `int8_max_pool2.sv` → [int8_max_pool2_7af1883049.sv](common/int8_max_pool2_7af1883049.sv)
- `int8_outer_product_4x4.sv` → [int8_outer_product_4x4_cee69d734f.sv](common/int8_outer_product_4x4_cee69d734f.sv)
- `int8_requantize_relu.sv` → [int8_requantize_relu_005e3f0635.sv](common/int8_requantize_relu_005e3f0635.sv)
- `int8_stream_gap.sv` → [int8_stream_gap_54922f62b9.sv](common/int8_stream_gap_54922f62b9.sv)
- `int8_weight_tile_loader.sv` → [int8_weight_tile_loader_581be3476b.sv](common/int8_weight_tile_loader_581be3476b.sv)
- `m30_network_replay.sv` → [m30_network_replay_f81f05902d.sv](common/m30_network_replay_f81f05902d.sv)
- `occupancy_mailbox.sv` → [occupancy_mailbox_77e3f5e48b.sv](common/occupancy_mailbox_77e3f5e48b.sv)
- `occupancy_service_soc.sv` → [occupancy_service_soc_8e02eb11ae.sv](common/occupancy_service_soc_8e02eb11ae.sv)
- `picorv32_accel_soc_host.sv` → [picorv32_accel_soc_host_bcc3fad12d.sv](common/picorv32_accel_soc_host_bcc3fad12d.sv)
- `simple_dual_port_bram_32.sv` → [simple_dual_port_bram_32_e016a6dd21.sv](common/simple_dual_port_bram_32_e016a6dd21.sv)
- `simple_dual_port_bram_8.sv` → [simple_dual_port_bram_8_1390076600.sv](common/simple_dual_port_bram_8_1390076600.sv)
