wudidamaozi/signal_sensing_accelerator/report/requirements_matrix.md

# 与AMD自主选题指南的对应

依据用户提供的2026 FPGA赛道AMD选题指南第3.3节，具体PDF身份在研究记录中保存。本文是条款对应说明，不改写主办方要求。

| 条款 | 本包内容与边界 |
|---|---|
| 3.3.3.1 工具 | 已说明实际Vivado/Vitis HLS2020.2；没有伪称推荐版本2026.1/2025.2的结果。提供重建脚本和冻结源 |
| 3.3.3.2 板卡 | PYNQ-Z2、XC7Z020CLG400-1；实测输出、镜像身份、参考比对见证据 |
| 3.3.3.3 开源 | 自研MIT、第三方独立许可；干净仓库与工程包一致，不上传完整研发历史 |
| 3.3.5.1 工程 | RTL、实际HLS C++、RISC-V C、主机/网页；仿真入口、黄金向量、资源时序报告、bit/LTX和板上运行入口 |
| PS侧软件 | 当前USB/JTAG纯PL方案无PS软件、无需HWH/SD卡；按实际采用实现提交，不伪造PS工程 |
| 3.3.5.2 Skill | 2个独立可运行技能、3个流程指南；说明适用/使用/失效条件、观察来源和正反例。通用PYNQ技能是主机对象与文件测试，不冒充新板卡实测 |
| 3.3.5.3 报告 | `design_report.md`、`reproduction.md`、`ai_collaboration.jsonl`、指标与架构图；正式模板PDF仍需与当前数据同步并人工审核 |
| 3.3.5.4 目录 | 根目录采用README/src/sim/build/board/data/skill/report；英文路径。约定入口及Git配置保留标准名称 |

## 不属于“工程包已经做好”的自动结论

本包不替代三分钟演示视频、承诺与授权签署件、平台表单、最终技术报告PDF、作品全貌照。平台要求RAR时，应上传真正的RAR；ZIP仅作同内容备份，不能改扩展名冒充RAR。上传前核对平台大小限制、报告模板、匿名要求、Github链接与可访问性。

舍友已有Word报告在研发仓库中保留，未以旧数据版本冒充本次封版报告，也未覆盖其个人编辑。写正式报告时应以本包当前表格、架构和证据为准。

## 2026-11-01 文件补齐

- 正式设计报告：基于FPGA的信号感知加速系统技术文档.pdf和基于FPGA的信号感知加速系统技术文档.docx，已确认V8，共28页。
- 四方数据与图表：four_method_board_results.csv、figures和evidence，包括纯CPU对照。
- 大模型协作：ai_collaboration.md为正式过程整理；ai_collaboration.jsonl保留原始选段；Skill和skill_fix保留使用说明、自测及纠错证据。
- 工程：保留src/sim/build/board/data/skill/report推荐结构；补入两项CPU-only依赖与分类完整重评功能，未把开发历史、缓存、训练环境和完整训练数据带入。
- 独立RAR工程包由发布流程在仓库外生成，避免将归档重复塞进源码仓库。视频、签署授权书、平台上传和最终人工确认仍由参赛者按平台要求办理。
