wudidamaozi/signal_sensing_accelerator/report/ai_collaboration.md

# 大模型辅助设计与工程验证

本项目将大模型辅助贯穿源码分析、候选实现、测试脚本编写与工具排错，形成“约束定义—方案生成—工程验证—结果反馈”的迭代开发流程。开发围绕既定CNN模型、整数计算规则和4×8并行规模展开，通过仿真、布局布线及实板结果评价候选方案，使设计迭代与工程验证相互衔接。

（1）面向固定计算规模的架构优化。针对占用CNN中供数、计算与后处理的衔接问题，大模型辅助分析数据通路和控制流程，参与候选RTL实现与测试脚本准备。最终设计在32PE规模下采用四bank按需取窗、权重驻留、A预取与C后处理缓冲，并通过层内自主调度减少CPU逐块组织任务的开销。方案取舍结合数值一致性、实现资源和实板周期进行判断，形成面向目标一维CNN的供数与执行组织。

（2）面向多种实现的验证与结果整理。围绕纯CPU、im2col＋GEMM、hls4ml和自研加速器，利用大模型辅助整理测试入口、核对配置并分析工具输出。通过逐层整数结果比对、模型与镜像身份检查，以及明确的计时范围，建立从计算正确性到硬件性能的验证链，支撑两项任务的四方对照。

（3）将研发经验沉淀为可复用技能。对整数推理核验、部署预检、资源时序分析和实验取证等重复工作，整理操作步骤、输入输出、适用范围与常见问题，形成配套脚本和Skill。路径问题采用失败复现、修正自测与回滚复验确认，将一次性排错经验转化为后续工程可沿用的方法。

上述内容依据研发记录归纳整理，相关交互选段、脚本和验证结果随工程资料保存。

原始交互选段保留于ai_collaboration.jsonl；工具输出和路径修正见evidence与skill_fix。流程图为研发过程整理，不是无人干预的智能体系统。
