wudidamaozi/signal_sensing_accelerator/report/path_notes.md

# Paths and evidence

Windows Vivado2020.2运行路径（包括父目录）使用ASCII。第一次导出放在中文父目录，PRJ的ASCII写入在编译前失败；改到独立英文路径后两任务动态仿真均通过。研发旧文件未删除。公开副本的历史日志与JSON中的本机路径用标记脱敏，数值、错误文字和源SHA保留；这些日志不是要求接收方复用原电脑盘符。
