wudidamaozi/signal_sensing_accelerator/report/four_method_board_results.csv

task | method | board_measured | cycles_min | cycles_max | latency_min_ms | latency_max_ms | unique_inputs | archived_calls | nominal_mhz | cpu_ram_bytes | lut | ff | bram36 | dsp | setup_ns | hold_ns | model_sha256
classification | RISC-V CPU-only C | True | 72713190 | 72713190 | 1454.2638 | 1454.2638 | 1 | 4 | 50 | 131072 | 2827 | 3541 | 32.0 | 4 | 10.152 | 0.049 | 8f1dd19eb42ca02815781e9de03621ac232c86db1327c0c4a7e4ea1e01a861f3
classification | Caffe im2col port + 4x8 GEMM | True | 1554656 | 1554656 | 31.09312 | 31.09312 | 1 | 1 | 50 | 16384 | 7473 | 7349 | 18.5 | 36 | 2.951 | 0.024 | 8f1dd19eb42ca02815781e9de03621ac232c86db1327c0c4a7e4ea1e01a861f3
classification | hls4ml hardware | True | 46283 | 46283 | 0.92566 | 0.92566 | 1 | 2 | 50 | 16384 | 36386 | 42260 | 17.0 | 68 | 2.288 | 0.007 | 8f1dd19eb42ca02815781e9de03621ac232c86db1327c0c4a7e4ea1e01a861f3
classification | custom 4x8 accelerator | True | 44343 | 44343 | 0.88686 | 0.88686 | 1 | 2 | 50 | 16384 | 7484 | 7350 | 18.5 | 36 | 3.02 | 0.056 | 8f1dd19eb42ca02815781e9de03621ac232c86db1327c0c4a7e4ea1e01a861f3
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
