wudidamaozi/signal_sensing_accelerator/src/rtl/common/occupancy_hls4ml_mux_104411_8_1_1_a3a8b39f8d.v

// ==============================================================
// Vitis HLS - High-Level Synthesis from C, C++ and OpenCL v2020.2 (64-bit)
// Copyright 1986-2020 Xilinx, Inc. All Rights Reserved.
// ==============================================================

`timescale 1ns/1ps

module occupancy_hls4ml_mux_104411_8_1_1 #(
parameter
    ID                = 0,
    NUM_STAGE         = 1,
    din0_WIDTH       = 32,
    din1_WIDTH       = 32,
    din2_WIDTH       = 32,
    din3_WIDTH       = 32,
    din4_WIDTH       = 32,
    din5_WIDTH       = 32,
    din6_WIDTH       = 32,
    din7_WIDTH       = 32,
    din8_WIDTH       = 32,
    din9_WIDTH       = 32,
    din10_WIDTH       = 32,
    din11_WIDTH       = 32,
    din12_WIDTH       = 32,
    din13_WIDTH       = 32,
    din14_WIDTH       = 32,
    din15_WIDTH       = 32,
    din16_WIDTH       = 32,
    din17_WIDTH       = 32,
    din18_WIDTH       = 32,
    din19_WIDTH       = 32,
    din20_WIDTH       = 32,
    din21_WIDTH       = 32,
    din22_WIDTH       = 32,
    din23_WIDTH       = 32,
    din24_WIDTH       = 32,
    din25_WIDTH       = 32,
    din26_WIDTH       = 32,
    din27_WIDTH       = 32,
    din28_WIDTH       = 32,
    din29_WIDTH       = 32,
    din30_WIDTH       = 32,
    din31_WIDTH       = 32,
    din32_WIDTH       = 32,
    din33_WIDTH       = 32,
    din34_WIDTH       = 32,
    din35_WIDTH       = 32,
    din36_WIDTH       = 32,
    din37_WIDTH       = 32,
    din38_WIDTH       = 32,
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
wire [7 : 0]         mux_6_1;
wire [7 : 0]         mux_6_2;
wire [7 : 0]         mux_6_3;
wire [7 : 0]         mux_6_4;
wire [7 : 0]         mux_6_5;
wire [7 : 0]         mux_6_6;
wire [7 : 0]         mux_6_7;
wire [7 : 0]         mux_6_8;
wire [7 : 0]         mux_6_9;
wire [7 : 0]         mux_6_10;
wire [7 : 0]         mux_6_11;
wire [7 : 0]         mux_6_12;
wire [7 : 0]         mux_6_13;
wire [7 : 0]         mux_6_14;
wire [7 : 0]         mux_6_15;
wire [7 : 0]         mux_6_16;
// level 7 signals
wire [7 : 0]         mux_7_0;
wire [7 : 0]         mux_7_1;
wire [7 : 0]         mux_7_2;
wire [7 : 0]         mux_7_3;
wire [7 : 0]         mux_7_4;
wire [7 : 0]         mux_7_5;
wire [7 : 0]         mux_7_6;
wire [7 : 0]         mux_7_7;
wire [7 : 0]         mux_7_8;
// level 8 signals
wire [7 : 0]         mux_8_0;
wire [7 : 0]         mux_8_1;
wire [7 : 0]         mux_8_2;
wire [7 : 0]         mux_8_3;
wire [7 : 0]         mux_8_4;
// level 9 signals
wire [7 : 0]         mux_9_0;
wire [7 : 0]         mux_9_1;
wire [7 : 0]         mux_9_2;
// level 10 signals
wire [7 : 0]         mux_10_0;
wire [7 : 0]         mux_10_1;
// level 11 signals
wire [7 : 0]         mux_11_0;

assign sel = din1044;
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
