wudidamaozi/signal_sensing_accelerator/src/rtl/common/occupancy_hls4ml_mux_646_32_1_1_3518e2d780.v

// ==============================================================
// Vitis HLS - High-Level Synthesis from C, C++ and OpenCL v2020.2 (64-bit)
// Copyright 1986-2020 Xilinx, Inc. All Rights Reserved.
// ==============================================================

`timescale 1ns/1ps

module occupancy_hls4ml_mux_646_32_1_1 #(
parameter
    ID                = 0,
    NUM_STAGE         = 1,
    din0_WIDTH       = 32,
    din1_WIDTH       = 32,
    din2_WIDTH       = 32,
    din3_WIDTH       = 32,
    din4_WIDTH       = 32,
    din5_WIDTH       = 32,
    din6_WIDTH       = 32,
    din7_WIDTH       = 32,
    din8_WIDTH       = 32,
    din9_WIDTH       = 32,
    din10_WIDTH       = 32,
    din11_WIDTH       = 32,
    din12_WIDTH       = 32,
    din13_WIDTH       = 32,
    din14_WIDTH       = 32,
    din15_WIDTH       = 32,
    din16_WIDTH       = 32,
    din17_WIDTH       = 32,
    din18_WIDTH       = 32,
    din19_WIDTH       = 32,
    din20_WIDTH       = 32,
    din21_WIDTH       = 32,
    din22_WIDTH       = 32,
    din23_WIDTH       = 32,
    din24_WIDTH       = 32,
    din25_WIDTH       = 32,
    din26_WIDTH       = 32,
    din27_WIDTH       = 32,
    din28_WIDTH       = 32,
    din29_WIDTH       = 32,
    din30_WIDTH       = 32,
    din31_WIDTH       = 32,
    din32_WIDTH       = 32,
    din33_WIDTH       = 32,
    din34_WIDTH       = 32,
    din35_WIDTH       = 32,
    din36_WIDTH       = 32,
    din37_WIDTH       = 32,
    din38_WIDTH       = 32,
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
assign mux_2_11 = (sel[1] == 0)? mux_1_22 : mux_1_23;
assign mux_2_12 = (sel[1] == 0)? mux_1_24 : mux_1_25;
assign mux_2_13 = (sel[1] == 0)? mux_1_26 : mux_1_27;
assign mux_2_14 = (sel[1] == 0)? mux_1_28 : mux_1_29;
assign mux_2_15 = (sel[1] == 0)? mux_1_30 : mux_1_31;

// Generate level 3 logic
assign mux_3_0 = (sel[2] == 0)? mux_2_0 : mux_2_1;
assign mux_3_1 = (sel[2] == 0)? mux_2_2 : mux_2_3;
assign mux_3_2 = (sel[2] == 0)? mux_2_4 : mux_2_5;
assign mux_3_3 = (sel[2] == 0)? mux_2_6 : mux_2_7;
assign mux_3_4 = (sel[2] == 0)? mux_2_8 : mux_2_9;
assign mux_3_5 = (sel[2] == 0)? mux_2_10 : mux_2_11;
assign mux_3_6 = (sel[2] == 0)? mux_2_12 : mux_2_13;
assign mux_3_7 = (sel[2] == 0)? mux_2_14 : mux_2_15;

// Generate level 4 logic
assign mux_4_0 = (sel[3] == 0)? mux_3_0 : mux_3_1;
assign mux_4_1 = (sel[3] == 0)? mux_3_2 : mux_3_3;
assign mux_4_2 = (sel[3] == 0)? mux_3_4 : mux_3_5;
assign mux_4_3 = (sel[3] == 0)? mux_3_6 : mux_3_7;

// Generate level 5 logic
assign mux_5_0 = (sel[4] == 0)? mux_4_0 : mux_4_1;
assign mux_5_1 = (sel[4] == 0)? mux_4_2 : mux_4_3;

// Generate level 6 logic
assign mux_6_0 = (sel[5] == 0)? mux_5_0 : mux_5_1;

// output logic
assign dout = mux_6_0;

endmodule
