wudidamaozi/signal_sensing_accelerator/src/hls/classification/firmware/nnet_utils/nnet_conv_stream.h

#ifndef NNET_CONV_STREAM_H_
#define NNET_CONV_STREAM_H_

#include "ap_shift_reg.h"
#include "hls_stream.h"
#include "nnet_common.h"
#include "nnet_dense.h"

namespace nnet {

enum class conv_implementation { linebuffer = 0, encoded = 1 };

// *************************************************
//       Encoded Implementation (Vlad's)
// *************************************************
template <unsigned K, unsigned S, unsigned W> unsigned scale_index_K_gte_S(const unsigned idx) {
    #pragma HLS INLINE

    if (idx < K - S) {
        return idx;
    }

    constexpr unsigned nW = ((W - K) / S) * S + K;           // Nearest W without unused pixels on the right
    constexpr unsigned sW = (DIV_ROUNDUP(K, S) - 1) * S + K; // Scaled W that behaves like original W
    if (idx >= nW) {
        return sW;
    }

    const unsigned r = nW - idx;
    if (r <= K - S) {
        return sW - r;
    }

    return K - S + (idx - (K - S)) % S;
}

template <unsigned K, unsigned S, unsigned W> unsigned scale_index_K_lt_S(const unsigned idx) {
    #pragma HLS INLINE

    if (idx < S - K) {
        return idx;
    }

    constexpr unsigned nW = ((W - K) / S) * S + K;           // Nearest W without unused pixels on the right
    constexpr unsigned sW = (DIV_ROUNDUP(S, K) - 1) * S + K; // Scaled W that behaves like original W
    if (idx >= nW) {
        return sW;
    }

    const unsigned r = nW - idx;
    if (r <= S - K) {
        return sW - r;
    }

    return S - K + (idx - (S - K)) % S;
}

template <unsigned K, unsigned S, unsigned W> class scale_index_regular {
  public:
    static unsigned scale_index(const unsigned idx) {
        #pragma HLS INLINE

        if (K >= S) {
            return scale_index_K_gte_S<K, S, W>(idx);
        } else {
            return scale_index_K_lt_S<K, S, W>(idx);
        }
    }
};

template <unsigned K, unsigned S, unsigned W> class scale_index_unscaled {
  public:
    static unsigned scale_index(const unsigned idx) {
        #pragma HLS INLINE
        return idx;
    }
};

template <class data_T, class res_T, typename CONFIG_T>
void mult_buffer(hls::stream<typename data_T::value_type> data_window[CONFIG_T::kernel_size * CONFIG_T::n_chan],
                 res_T &res_pack, hls::stream<res_T> &res_stream, unsigned &outputs_ready,
                 typename CONFIG_T::weight_t weights[CONFIG_T::kernel_size * CONFIG_T::n_chan * CONFIG_T::n_filt],
                 typename CONFIG_T::bias_t biases[CONFIG_T::n_filt]) {
    #pragma HLS INLINE

    typename data_T::value_type data[CONFIG_T::kernel_size * CONFIG_T::n_chan];
    #pragma HLS ARRAY_PARTITION variable = data complete
    typename res_T::value_type res[CONFIG_T::n_filt];
    #pragma HLS ARRAY_PARTITION variable = res complete

InitData:
    for (int id = 0; id < CONFIG_T::kernel_size * CONFIG_T::n_chan; id++) {
        #pragma HLS UNROLL
        data[id] = data_window[id].read();
    }

    #pragma HLS INLINE recursive
    CONFIG_T::mult_config::template kernel<typename data_T::value_type, typename res_T::value_type,
                                           typename CONFIG_T::mult_config>::dense(data, res, weights, biases);

CastLoop:
    for (unsigned jj = 0; jj < CONFIG_T::n_filt; jj++) {
        #pragma HLS UNROLL
        if (res_T::size / CONFIG_T::n_filt == 1) {
            res_pack[jj] = res[jj];
        } else {
            res_pack[outputs_ready * CONFIG_T::n_filt + jj] = res[jj];
        }
    }

    if (res_T::size / CONFIG_T::n_filt == 1) {
        res_stream.write(res_pack);
    } else {
        if (outputs_ready == (res_T::size / CONFIG_T::n_filt) - 1) {
            res_stream.write(res_pack);
            outputs_ready = 0;
        } else {
            outputs_ready++;
        }
    }
}

template <class data_T, class res_T, typename CONFIG_T>
void compute_output_encoded(const data_T &in_elem,
                            hls::stream<typename data_T::value_type> data_window[CONFIG_T::kernel_size * CONFIG_T::n_chan],
                            hls::stream<res_T> &res, res_T &res_pack, unsigned &outputs_ready,
                            typename CONFIG_T::weight_t weights[CONFIG_T::kernel_size * CONFIG_T::n_chan * CONFIG_T::n_filt],
                            typename CONFIG_T::bias_t biases[CONFIG_T::n_filt], ap_uint<CONFIG_T::kernel_size> *pixel_idx) {
    #pragma HLS INLINE

MultLoop:
    for (unsigned p = 0; p < data_T::size / CONFIG_T::n_chan; p++) {
        #pragma HLS PIPELINE II = CONFIG_T::reuse_factor
    CopyDataFilt:
        for (unsigned f = 0; f < CONFIG_T::kernel_size; f++) {
            #pragma HLS UNROLL
        CopyDataChan:
            for (unsigned c = 0; c < CONFIG_T::n_chan; c++) {
                #pragma HLS UNROLL
                if (pixel_idx[p][f])
                    data_window[f * CONFIG_T::n_chan + c].write(in_elem[p * CONFIG_T::n_chan + c]);
            }
        }
        if (pixel_idx[p][CONFIG_T::kernel_size - 1]) {
            mult_buffer<data_T, res_T, CONFIG_T>(data_window, res_pack, res, outputs_ready, weights, biases);
        }
    }
}

// *************************************************
//       Line Buffer Implementation (Phil's)
// *************************************************
template <class data_T, typename CONFIG_T>
void kernel_shift_1d(const data_T &in_elem,
                     typename data_T::value_type kernel_window[CONFIG_T::filt_width * CONFIG_T::n_chan]) {
    #pragma HLS inline

    // Shift kernel_window by one step to the left (manual shift operation)
    static const int filt_width = CONFIG_T::filt_width - 1;
KernelShiftWidth:
    for (int i_iw = 0; i_iw < filt_width; i_iw++) {
        #pragma HLS PIPELINE II = 1
    KernelShiftChannel:
        for (unsigned i_ic = 0; i_ic < CONFIG_T::n_chan; i_ic++) {
            #pragma HLS UNROLL
            // Shift every element in kernel_window to the left
            kernel_window[i_iw * CONFIG_T::n_chan + i_ic] = kernel_window[(i_iw + 1) * CONFIG_T::n_chan + i_ic];
        }
    }

    // Insert shift_buffer column into right-most column of kernel
    static const int lastheight = (CONFIG_T::filt_width - 1) * CONFIG_T::n_chan;
KernelPushChannel:
    for (int i_ic = 0; i_ic < CONFIG_T::n_chan; i_ic++) {
        #pragma HLS UNROLL
        kernel_window[lastheight + i_ic] = in_elem[i_ic];
    }
}

template <class data_T, typename CONFIG_T>
void kernel_shift_2d(
    typename data_T::value_type shift_buffer[CONFIG_T::filt_height][CONFIG_T::n_chan],
    typename data_T::value_type kernel_window[CONFIG_T::filt_width * CONFIG_T::filt_height * CONFIG_T::n_chan]) {
    #pragma HLS inline

    // Shift kernel_window by one step to the left (manual shift operation)
    static const int filt_width = CONFIG_T::filt_width - 1;
KernelShiftWidth:
    for (int i_iw = 0; i_iw < filt_width; i_iw++) {
        #pragma HLS PIPELINE II = 1
    KernelShiftHeight:
        for (unsigned i_ih = 0; i_ih < CONFIG_T::filt_height; i_ih++) {
        KernelShiftChannel:
            for (unsigned i_ic = 0; i_ic < CONFIG_T::n_chan; i_ic++) {
                // Shift every element in kernel_window to the left
                kernel_window[i_ih * CONFIG_T::filt_width * CONFIG_T::n_chan + i_iw * CONFIG_T::n_chan + i_ic] =
                    kernel_window[i_ih * CONFIG_T::filt_width * CONFIG_T::n_chan + (i_iw + 1) * CONFIG_T::n_chan + i_ic];
            }
        }
    }

    // Insert shift_buffer column into right-most column of kernel
    static const int lastheight = (CONFIG_T::filt_width - 1) * CONFIG_T::n_chan;
KernelPushHeight:
    for (int i_ih = 0; i_ih < CONFIG_T::filt_height; i_ih++) {
        #pragma HLS UNROLL
    KernelPushChannel:
        for (int i_ic = 0; i_ic < CONFIG_T::n_chan; i_ic++) {
            kernel_window[lastheight + i_ih * CONFIG_T::filt_width * CONFIG_T::n_chan + i_ic] = shift_buffer[i_ih][i_ic];
        }
    }
}

template <class data_T, typename CONFIG_T>
void shift_line_buffer(
    const data_T &in_elem,
    ap_shift_reg<typename data_T::value_type, CONFIG_T::in_width> line_buffer[MAX(CONFIG_T::filt_height - 1, 1)]
                                                                             [CONFIG_T::n_chan],
    typename data_T::value_type kernel_window[CONFIG_T::filt_height * CONFIG_T::filt_width * CONFIG_T::n_chan]) {

    #pragma HLS PIPELINE

    // Temporary buffer for popped (shifted) elements
    typename data_T::value_type shift_buffer[CONFIG_T::filt_height][CONFIG_T::n_chan];
    #pragma HLS ARRAY_PARTITION variable = shift_buffer complete dim = 0

UpdateBuffer:
    for (int i_ic = 0; i_ic < CONFIG_T::n_chan; i_ic++) {
        #pragma HLS UNROLL

        // Insert pixel(s) at end of shift buffer
        shift_buffer[CONFIG_T::filt_height - 1][i_ic] = in_elem[i_ic];
    }

LineBufferDataIn:
    for (int i_ic = 0; i_ic < CONFIG_T::n_chan; i_ic++) {
    // Shift the shift buffer into the line buffer
    LineBufferShift:
        for (unsigned i_ih = 1; i_ih < CONFIG_T::filt_height; i_ih++) {
            #pragma HLS UNROLL
            typename data_T::value_type pop_elem = line_buffer[i_ih - 1][i_ic].shift(
                shift_buffer[CONFIG_T::filt_height - i_ih][i_ic]); // Shift the line buffer, return the popped pixel
            shift_buffer[CONFIG_T::filt_height - i_ih - 1][i_ic] =
                pop_elem; // Popped element placed back into shift_buffer, one row up.
        }
    }
    kernel_shift_2d<data_T, CONFIG_T>(shift_buffer, kernel_window);
}

template <class data_T, class res_T, typename CONFIG_T>
void compute_output_buffer_2d(
    const data_T &in_elem,
    ap_shift_reg<typename data_T::value_type, CONFIG_T::in_width> line_buffer[MAX(CONFIG_T::filt_height - 1, 1)]
                                                                             [CONFIG_T::n_chan],
    hls::stream<res_T> &res_stream,
    typename CONFIG_T::weight_t weights[CONFIG_T::kernel_size * CONFIG_T::n_chan * CONFIG_T::n_filt],
    typename CONFIG_T::bias_t biases[CONFIG_T::n_filt]) {
    #pragma HLS INLINE OFF

    // Thresholds
    const static int lShiftX = CONFIG_T::filt_width - 1;
    const static int lShiftY = CONFIG_T::filt_height - 1;

    // Counters
    static int pX = 0; // Pixel X
    static int pY = 0; // Pixel Y

    static int sX = 0; // Stride X
    static int sY = 0; // Stride Y

    static typename data_T::value_type kernel_data[CONFIG_T::filt_height * CONFIG_T::filt_width * CONFIG_T::n_chan];
    #pragma HLS ARRAY_PARTITION variable = kernel_data complete

    typename res_T::value_type res_out[CONFIG_T::n_filt];
    #pragma HLS ARRAY_PARTITION variable = res_out complete dim = 0

    res_T res_pack;
    PRAGMA_DATA_PACK(res_pack)

    // Add pixel to buffer
    nnet::shift_line_buffer<data_T, CONFIG_T>(in_elem, line_buffer, kernel_data);

    // Check to see if we have a full kernel
    if ((sX - lShiftX) == 0 && (sY - lShiftY) == 0 && pY > lShiftY - 1 && pX > lShiftX - 1) {

        // Dense multiply
        // #pragma HLS INLINE recursive
        CONFIG_T::mult_config::template kernel<typename data_T::value_type, typename res_T::value_type,
                                               typename CONFIG_T::mult_config>::dense(kernel_data, res_out, weights, biases);

    // Pack output
    CastLoop:
        for (unsigned i_ic = 0; i_ic < CONFIG_T::n_filt; i_ic++) {
            #pragma HLS UNROLL
            res_pack[i_ic] = res_out[i_ic];
        }

        // Write output to stream when output ready
        res_stream.write(res_pack);
    }

    // Counter Housekeeping
    if (pX + 1 == CONFIG_T::in_width) // Includes padding, end of line (padded)
    {
        pX = 0;
        sX = 0;
        if (pY + 1 == CONFIG_T::in_height) { // Reached bottom of image
            pY = 0;
            sY = 0;
        } else {
            pY = pY + 1;
            // Update stride (threshold) ? subtract stride : increment stride
            sY = ((sY - lShiftY) == 0) ? sY - CONFIG_T::stride_height + 1 : sY + 1;
        }
    } else {
        pX = pX + 1;
        // Update stride (threshold) ? subtract stride : increment stride
        sX = ((sX - lShiftX) == 0) ? sX - CONFIG_T::stride_width + 1 : sX + 1;
    }
}

// Conv 1D compute output
template <class data_T, class res_T, typename CONFIG_T>
void compute_output_buffer_1d(
    const data_T &in_elem, hls::stream<res_T> &res_stream,
    typename CONFIG_T::weight_t weights[CONFIG_T::kernel_size * CONFIG_T::n_chan * CONFIG_T::n_filt],
    typename CONFIG_T::bias_t biases[CONFIG_T::n_filt]) {
    #pragma HLS INLINE OFF

    // Thresholds
    const static int lShiftX = CONFIG_T::filt_width - 1;

    // Counters
    static int pX = 0; // pixel counter
    static int sX = 0; // stride counter

    static typename data_T::value_type kernel_data[CONFIG_T::filt_width * CONFIG_T::n_chan];
    #pragma HLS ARRAY_PARTITION variable = kernel_data complete

    typename res_T::value_type res_out[CONFIG_T::n_filt];
    #pragma HLS ARRAY_PARTITION variable = res_out complete dim = 0

    res_T res_pack;
    PRAGMA_DATA_PACK(res_pack)

    // Add pixel to buffer
    nnet::kernel_shift_1d<data_T, CONFIG_T>(in_elem, kernel_data);

    // Check to see if we have a full kernel
    if ((sX - lShiftX) == 0 && pX > lShiftX - 1) {

        // Dense multiply
        // #pragma HLS INLINE recursive
        CONFIG_T::mult_config::template kernel<typename data_T::value_type, typename res_T::value_type,
                                               typename CONFIG_T::mult_config>::dense(kernel_data, res_out, weights, biases);

    // Pack output
    CastLoop:
        for (unsigned i_ic = 0; i_ic < CONFIG_T::n_filt; i_ic++) {
            #pragma HLS UNROLL
            res_pack[i_ic] = res_out[i_ic];
        }

        // Write output to stream when output ready
        res_stream.write(res_pack);
    }

    // Counter Housekeeping
    if (pX + 1 == CONFIG_T::in_width) // Includes padding, end of line (padded)
    {
        pX = 0;
        sX = 0;
    } else {
        pX = pX + 1;
        // Update stride (threshold) ? subtract stride : increment stride
        sX = ((sX - lShiftX) == 0) ? sX - CONFIG_T::stride_width + 1 : sX + 1;
    }
}

} // namespace nnet
#endif
