wudidamaozi/signal_sensing_accelerator/src/hls/classification/firmware/nnet_utils/nnet_helpers.h

#ifndef NNET_HELPERS_H
#define NNET_HELPERS_H

#include "hls_stream.h"
#include <algorithm>
#include <fstream>
#include <iostream>
#include <map>
#include <math.h>
#include <stdio.h>
#include <stdlib.h>
#include <vector>

namespace nnet {

#ifndef __SYNTHESIS__

#ifndef WEIGHTS_DIR
#define WEIGHTS_DIR "weights"
#endif

template <class T, size_t SIZE> void load_weights_from_txt(T *w, const char *fname) {

    std::string full_path = std::string(WEIGHTS_DIR) + "/" + std::string(fname);
    std::ifstream infile(full_path.c_str(), std::ios::binary);

    if (infile.fail()) {
        std::cerr << "ERROR: file " << std::string(full_path) << " does not exist" << std::endl;
        exit(1);
    }

    std::string line;
    if (std::getline(infile, line)) {
        std::istringstream iss(line);
        std::string token;

        size_t i = 0;
        while (std::getline(iss, token, ',')) {
            std::istringstream(token) >> w[i];
            i++;
        }

        if (SIZE != i) {
            std::cerr << "ERROR: Expected " << SIZE << " values";
            std::cerr << " but read only " << i << " values" << std::endl;
        }
    }
}

template <class T, size_t SIZE> void load_compressed_weights_from_txt(T *w, const char *fname) {

    std::string full_path = std::string(WEIGHTS_DIR) + "/" + std::string(fname);
    std::ifstream infile(full_path.c_str(), std::ios::binary);

    if (infile.fail()) {
        std::cerr << "ERROR: file " << std::string(fname) << " does not exist" << std::endl;
        exit(1);
    }

    std::string line;
    if (std::getline(infile, line)) {
        std::istringstream iss(line);
        std::string token;
        std::string extra_chars = "} ";

        size_t i = 0;
        while (std::getline(iss, token, '{')) {
            if (token.length() == 0) {
                continue;
            }
            for (char c : extra_chars) {
                token.erase(std::remove(token.begin(), token.end(), c), token.end());
            }
            if (token.back() == ',') {
                token.erase(token.end() - 1);
            }

            std::replace(token.begin(), token.end(), ',', ' ');
            std::istringstream structss(token);

            if (!(structss >> w[i].row_index >> w[i].col_index >> w[i].weight)) {
                std::cerr << "ERROR: Unable to parse file " << std::string(fname);
                exit(1);
            }
            i++;
        }

        if (SIZE != i) {
            std::cerr << "ERROR: Expected " << SIZE << " values";
            std::cerr << " but read only " << i << " values" << std::endl;
        }
    }
}

template <class T, size_t SIZE> void load_exponent_weights_from_txt(T *w, const char *fname) {

    std::string full_path = std::string(WEIGHTS_DIR) + "/" + std::string(fname);
    std::ifstream infile(full_path.c_str(), std::ios::binary);

    if (infile.fail()) {
        std::cerr << "ERROR: file " << std::string(fname) << " does not exist" << std::endl;
        exit(1);
    }

    std::string line;
    if (std::getline(infile, line)) {
        std::istringstream iss(line);
        std::string token;
        std::string extra_chars = "} ";

        size_t i = 0;
        while (std::getline(iss, token, '{')) {
            if (token.length() == 0) {
                continue;
            }
            for (char c : extra_chars) {
                token.erase(std::remove(token.begin(), token.end(), c), token.end());
            }
            if (token.back() == ',') {
                token.erase(token.end() - 1);
            }

            std::replace(token.begin(), token.end(), ',', ' ');
            std::istringstream structss(token);

            if (!(structss >> w[i].sign >> w[i].weight)) {
                std::cerr << "ERROR: Unable to parse file " << std::string(fname);
                exit(1);
            }
            i++;
        }

        if (SIZE != i) {
            std::cerr << "ERROR: Expected " << SIZE << " values";
            std::cerr << " but read only " << i << " values" << std::endl;
        }
    }
}
template <class srcType, class dstType, size_t SIZE> void convert_data(srcType *src, dstType *dst) {
    for (size_t i = 0; i < SIZE; i++) {
        dst[i] = dstType(src[i]);
    }
}

template <class srcType, class dstType, size_t SIZE> void convert_data(srcType *src, hls::stream<dstType> &dst) {
    for (size_t i = 0; i < SIZE / dstType::size; i++) {
        dstType ctype;
        for (size_t j = 0; j < dstType::size; j++) {
            ctype[j] = typename dstType::value_type(src[i * dstType::size + j]);
        }
        dst.write(ctype);
    }
}

template <class srcType, class dstType, size_t SIZE> void convert_data(hls::stream<srcType> &src, dstType *dst) {
    for (size_t i = 0; i < SIZE / srcType::size; i++) {
        srcType ctype = src.read();
        for (size_t j = 0; j < srcType::size; j++) {
            dst[i * srcType::size + j] = dstType(ctype[j]);
        }
    }
}

extern bool trace_enabled;
extern std::map<std::string, void *> *trace_outputs;
extern size_t trace_type_size;

template <class data_T, class save_T> void save_output_array(data_T *data, save_T *ptr, size_t layer_size) {
    for (int i = 0; i < layer_size; i++) {
        ptr[i] = save_T(data[i]);
    }
}

template <class data_T, class save_T> void save_output_array(hls::stream<data_T> &data, save_T *ptr, size_t layer_size) {
    for (size_t i = 0; i < layer_size / data_T::size; i++) {
        data_T ctype = data.read();
        for (size_t j = 0; j < data_T::size; j++) {
            ptr[i * data_T::size + j] = save_T(ctype[j]);
        }
        data.write(ctype);
    }
}

// We don't want to include save_T in this function because it will be inserted into myproject.cpp
// so a workaround with element size is used
template <class data_T> void save_layer_output(data_T *data, const char *layer_name, size_t layer_size) {
    if (!trace_enabled)
        return;

    if (trace_outputs) {
        if (trace_outputs->count(layer_name) > 0) {
            if (trace_type_size == 4) {
                save_output_array<data_T, float>(data, (float *)(*trace_outputs)[layer_name], layer_size);
            } else if (trace_type_size == 8) {
                save_output_array<data_T, double>(data, (double *)(*trace_outputs)[layer_name], layer_size);
            } else {
                std::cout << "Unknown trace type!" << std::endl;
            }
        } else {
            std::cout << "Layer name: " << layer_name << " not found in debug storage!" << std::endl;
        }
    } else {
        std::ostringstream filename;
        filename << "./tb_data/" << layer_name << "_output.log"; // TODO if run as a shared lib, path should be ../tb_data
        std::fstream out;
        out.open(filename.str(), std::ios::app);
        assert(out.is_open());
        for (int i = 0; i < layer_size; i++) {
            out << float(data[i]) << " "; // We don't care about precision in text files
        }
        out << std::endl;
        out.close();
    }
}

template <class data_T> void save_layer_output(hls::stream<data_T> &data, const char *layer_name, size_t layer_size) {
    if (!trace_enabled)
        return;

    if (trace_outputs) {
        if (trace_outputs->count(layer_name) > 0) {
            if (trace_type_size == 4) {
                save_output_array<data_T, float>(data, (float *)(*trace_outputs)[layer_name], layer_size);
            } else if (trace_type_size == 8) {
                save_output_array<data_T, double>(data, (double *)(*trace_outputs)[layer_name], layer_size);
            } else {
                std::cout << "Unknown trace type!" << std::endl;
            }
        } else {
            std::cout << "Layer name: " << layer_name << " not found in debug storage!" << std::endl;
        }
    } else {
        std::ostringstream filename;
        filename << "./tb_data/" << layer_name << "_output.log"; // TODO if run as a shared lib, path should be ../tb_data
        std::fstream out;
        out.open(filename.str(), std::ios::app);
        assert(out.is_open());
        for (size_t i = 0; i < layer_size / data_T::size; i++) {
            data_T ctype = data.read();
            for (size_t j = 0; j < data_T::size; j++) {
                out << float(ctype[j]) << " "; // We don't care about precision in text files
            }
            data.write(ctype);
        }
        out << std::endl;
        out.close();
    }
}

#endif

template <class src_T, class dst_T, size_t OFFSET, size_t SIZE> void copy_data(std::vector<src_T> src, dst_T dst[SIZE]) {
    typename std::vector<src_T>::const_iterator in_begin = src.cbegin() + OFFSET;
    typename std::vector<src_T>::const_iterator in_end = in_begin + SIZE;
    std::copy(in_begin, in_end, dst);
}

template <class src_T, class dst_T, size_t OFFSET, size_t SIZE>
void copy_data(std::vector<src_T> src, hls::stream<dst_T> &dst) {
    typename std::vector<src_T>::const_iterator in_begin = src.cbegin() + OFFSET;
    typename std::vector<src_T>::const_iterator in_end = in_begin + SIZE;

    size_t i_pack = 0;
    dst_T dst_pack;
    for (typename std::vector<src_T>::const_iterator i = in_begin; i != in_end; ++i) {
        dst_pack[i_pack++] = typename dst_T::value_type(*i);
        if (i_pack == dst_T::size) {
            i_pack = 0;
            dst.write(dst_pack);
        }
    }
}

template <class src_T, class dst_T, size_t OFFSET, size_t SIZE> void copy_data_axi(std::vector<src_T> src, dst_T dst[SIZE]) {
    for (auto i = 0; i < SIZE; i++)
        if (i == SIZE - 1) {
            dst[i].data = src[i];
            dst[i].last = 1;
        } else {
            dst[i].data = src[i];
            dst[i].last = 0;
        }
}

template <class res_T, size_t SIZE> void print_result(res_T result[SIZE], std::ostream &out, bool keep = false) {
    for (int i = 0; i < SIZE; i++) {
        out << result[i] << " ";
    }
    out << std::endl;
}

template <class res_T, size_t SIZE> void print_result(hls::stream<res_T> &result, std::ostream &out, bool keep = false) {
    for (int i = 0; i < SIZE / res_T::size; i++) {
        res_T res_pack = result.read();
        for (int j = 0; j < res_T::size; j++) {
            out << res_pack[j] << " ";
        }
        if (keep)
            result.write(res_pack);
    }
    out << std::endl;
}

template <class data_T, size_t SIZE> void fill_zero(data_T data[SIZE]) { std::fill_n(data, SIZE, 0.); }

template <class data_T, size_t SIZE> void fill_zero(hls::stream<data_T> &data) {
    for (int i = 0; i < SIZE / data_T::size; i++) {
        data_T data_pack;
        for (int j = 0; j < data_T::size; j++) {
            data_pack[j] = 0.;
        }
        data.write(data_pack);
    }
}

template <class dataType, unsigned int nrows> int read_file_1D(const char *filename, dataType data[nrows]) {
    FILE *fp;
    fp = fopen(filename, "r");
    if (fp == 0) {
        return -1;
    }
    // Read data from file
    float newval;
    for (int ii = 0; ii < nrows; ii++) {
        if (fscanf(fp, "%f\n", &newval) != 0) {
            data[ii] = newval;
        } else {
            return -2;
        }
    }
    fclose(fp);
    return 0;
}

template <class dataType, unsigned int nrows, unsigned int ncols>
int read_file_2D(const char *filename, dataType data[nrows][ncols]) {
    FILE *fp;
    fp = fopen(filename, "r");
    if (fp == 0) {
        return -1;
    }
    // Read data from file
    float newval;
    for (int ii = 0; ii < nrows; ii++) {
        for (int jj = 0; jj < ncols; jj++) {
            if (fscanf(fp, "%f\n", &newval) != 0) {
                data[ii][jj] = newval;
            } else {
                return -2;
            }
        }
    }
    fclose(fp);
    return 0;
}

template <class in_T, class out_T, int N_IN> void change_type(hls::stream<in_T> &in, hls::stream<out_T> &out) {
    in_T datareg;
    hls::stream<out_T> input_trunc;
    for (int ii = 0; ii < N_IN; ii++) {
        out << (out_T)in.read();
    }
}

template <class data_T, int N_IN> void hls_stream_debug(hls::stream<data_T> &data, hls::stream<data_T> &res) {
    data_T datareg;
    for (int ii = 0; ii < N_IN; ii++) {
        datareg = data.read();
        std::cout << "[" << ii << "]: " << datareg << std::endl;
        res << datareg;
    }
}

constexpr int ceillog2(int x) { return (x <= 2) ? 1 : 1 + ceillog2((x + 1) / 2); }

constexpr int floorlog2(int x) { return (x < 2) ? 0 : 1 + floorlog2(x / 2); }

constexpr int pow2(int x) { return x == 0 ? 1 : 2 * pow2(x - 1); }

} // namespace nnet

#endif
