wudidamaozi/signal_sensing_accelerator/(commit log)

2026-10-31 Release reproducible PYNQ-Z2 signal sensing accelerator competition package
    [occupancy_comparison.csv]
2026-11-01 Release final code, CPU baselines and V8 design report
    [four_method_board_results.csv]
